flashmandv/phillips-3246-smart/(threads)

Thread 1 (2024-01-11):

Display not turning on

sepodele, 2024-01-11:
I saw your post at https://github.com/mkorenko/esp-phillips-3200/issues/1 about the ghost commands. I actually had the same problem with my EP3243 and ESP8266. And changing to ESP32 S2 Mini fixed those issues just like in your case. Unfortunately that also led to the display not turning on unless the power to the ESP32 was removed completely (either by pulling the power to VBUS or by hitting the RST button). If not, the machine turns on but display doesn't. I have to touch the power button on the display and it will light up immediately.

I'm actually trying to make this work with TillFleish's ESPHome approach (https://github.com/TillFleisch/ESPHome-Philips-Smart-Coffee), but the problem seems to be universal.

Any thoughts on my wiring?
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

sepodele, 2024-01-12:
Changed the code to turn off and then on instead of the opposite. Also removed invert_power_pin: true. Looks like that fixed the issue.

Closed 2024-01-12.
