flashmandv/phillips-3246-smart/(commit log)

2024-01-05 Adding my code (beta version) with WiFi server that currently works on Phillips 3246 coffee machine
2024-01-05 Added the wiring schematics for ESP32 + little code cleanup
